Skrobson/SMIW/Hardware/PDF/Scheme.pdf

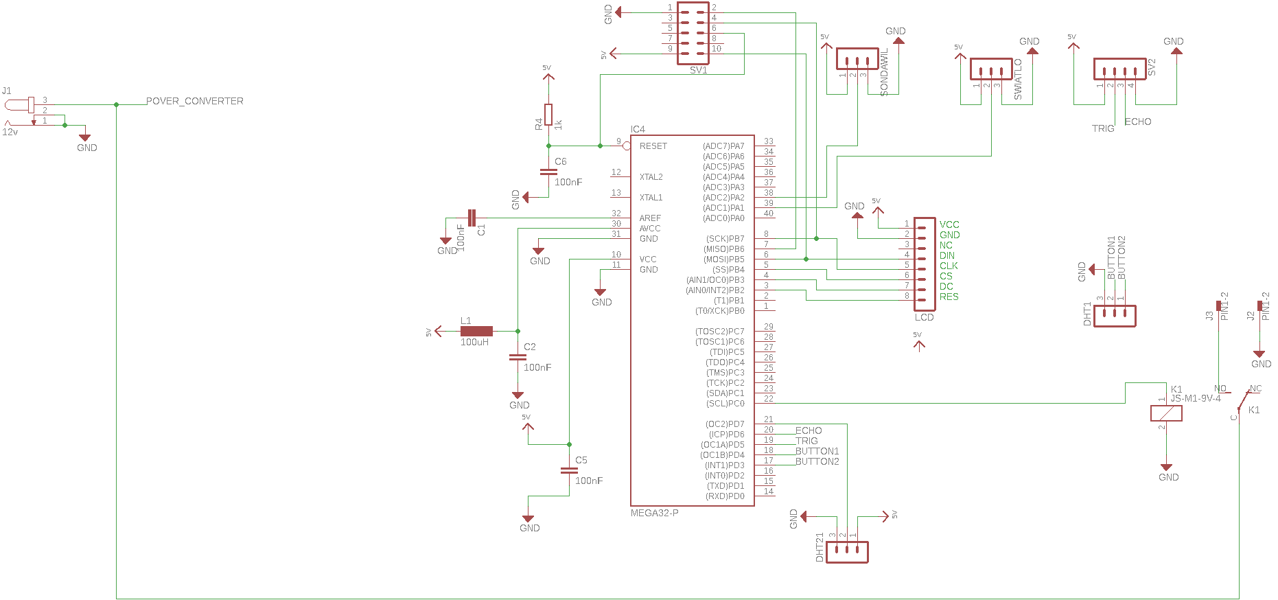
[picture p3: page 1]
