Skrobson/SMIW/Hardware/PDF/SchemePCB.pdf

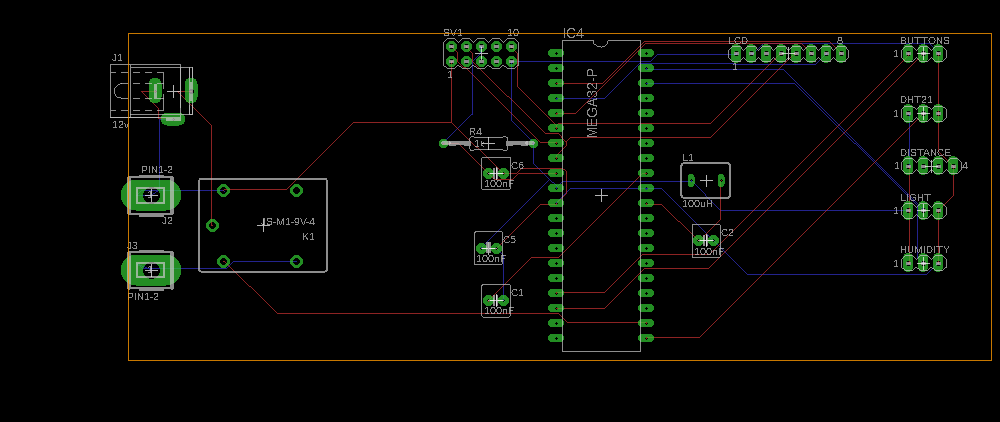
[picture p4: page 1]
