Skrobson/SMIW/Dokumentacja/Datasheet/mikrokontroler-avr-atmega32a-pu-dip.jpg

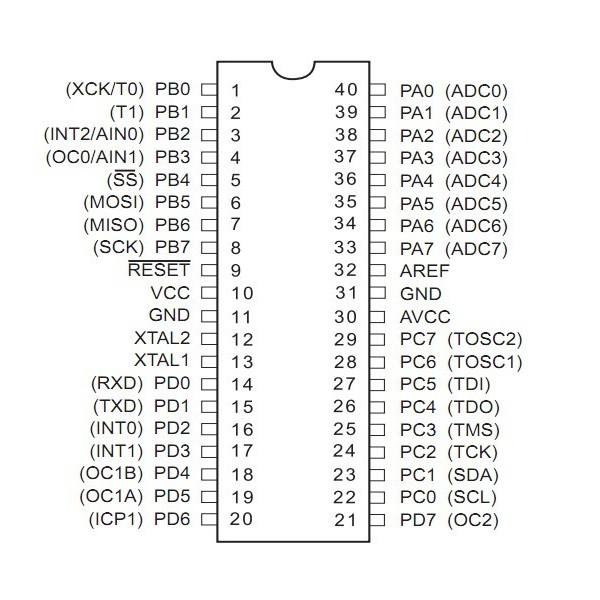
Dokumentacja/Datasheet/mikrokontroler-avr-atmega32a-pu-dip.jpg
