Skrobson/SMIW/Hardware/Eagle/schematPCB.brd

## EAGLE design Hardware/Eagle/schematPCB.brd (2018-09-15)

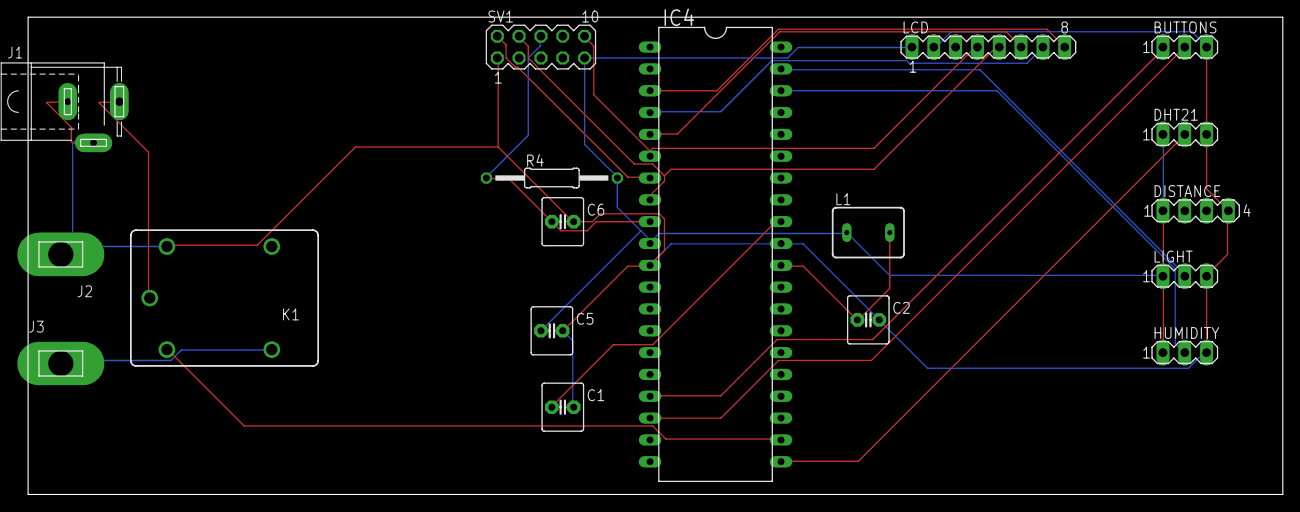
[picture p6: board schematPCB.brd from above]

Board: 2 copper layers, 146.0 x 55.5 mm, 18 parts (0 on the bottom side), 19 nets.

Parts:
BUTTONS: MA03-1
C1, C2, C5, C6: 100nF; C2.5-6
DHT21: MA03-1
DISTANCE: MA04-1
HUMIDITY: MA03-1
IC4: MEGA32-P; DIL40
J1: 12v; SPC4078
J2, J3: PIN1-2; 62221
K1: JS-M1-9V-4; JS-M
L1: 100uH; BS75
LCD: MA08-1
LIGHT: MA03-1
R4: 1k; 0207/15
SV1: MA05-2

Connections:
BUTTON1: BUTTONS.2, IC4.18
BUTTON2: BUTTONS.1, IC4.17
GND: BUTTONS.3, C1.2, C2.2, C5.2, C6.2, DHT21.3, DISTANCE.4, HUMIDITY.3, IC4.11, IC4.31, J1.1, J1.2, J2.1, K1.2, LCD.2, LIGHT.3, SV1.1
unnamed: IC4.39, LIGHT.2
unnamed: C6.1, IC4.9, R4.1, SV1.6
unnamed: IC4.6, LCD.4, SV1.10
unnamed: C1.1, IC4.32
unnamed: C2.1, IC4.30, L1.2
unnamed: IC4.8, LCD.5, SV1.4
unnamed: IC4.5, LCD.6
unnamed: IC4.4, LCD.7
unnamed: IC4.3, LCD.8
unnamed: DHT21.2, IC4.21
unnamed: J3.1, K1.NO
unnamed: HUMIDITY.2, IC4.38
unnamed: IC4.22, K1.1
unnamed: IC4.7, SV1.2
POVER_CONVERTER: J1.3, K1.C
VCC: C5.1, DHT21.1, DISTANCE.1, HUMIDITY.1, IC4.10, L1.1, LCD.1, LIGHT.1, R4.2, SV1.9
