Skrobson/SMIW/Software/SH1106.cpp

/*
 * SH1106.cpp
 *
 *  Created on: 28 cze 2018
 *      Author: skrobson
 */

#include "SH1106.h"
#include <util/delay.h>
#include <avr/pgmspace.h>

bool SH1106::initialized = false;
SH1106::SH1106() {

	if (!initialized)
	{
		spiInitMaster();


		restart();
		initialized = true;
	}
}

void SH1106::restart()
{
	DDRB |=(1<<PIN_CS);
		DDRB |=(1<<PIN_DC);
		DDRB |=(1<<PIN_RESET);

		PORTB &=~(1<<PIN_CS);

		PORTB |= (1<<PIN_RESET);
		_delay_ms(10);
		// Must reset LCD first!
		PORTB &= ~(1<<PIN_RESET);
		_delay_ms(10);
		PORTB |= (1<<PIN_RESET);

		command(0xAE);//--turn off oled panel
		command(0x02);//---set low column address
		command(0x10);//---set high column address
		command(0x40);//--set start line address  Set Mapping RAM Display Start Line (0x00~0x3F)
		command(0x81);//--set contrast control register
		command(0xA0);//--Set SEG/Column Mapping
		command(0xC0);//Set COM/Row Scan Direction
		command(0xA6);//--set normal display
		command(0xA8);//--set multiplex ratio(1 to 64)
		command(0x3F);//--1/64 duty
		command(0xD3);//-set display offset    Shift Mapping RAM Counter (0x00~0x3F)
		command(0x00);//-not offset
		command(0xd5);//--set display clock divide ratio/oscillator frequency
		command(0x80);//--set divide ratio, Set Clock as 100 Frames/Sec
		command(0xD9);//--set pre-charge period
		command(0xF1);//Set Pre-Charge as 15 Clocks & Discharge as 1 Clock
		command(0xDA);//--set com pins hardware configuration
		command(0x12);
		command(0xDB);//--set vcomh
		command(0x40);//Set VCOM Deselect Level
		command(0x20);//-Set Page Addressing Mode (0x00/0x01/0x02)
		command(0x02);//
		command(0xA4);// Disable Entire Display On (0xa4/0xa5)
		command(0xA6);// Disable Inverse Display On (0xa6/a7)
		command(0xAF);//--turn on oled panel

}

void SH1106::writeCmd(uint8_t data)
{
	PORTB &= ~(1<<PIN_DC);

	SPDR = data;
	while(! bit_is_set( SPSR, SPIF ));
}

void SH1106::write(uint8_t data)
{
	PORTB |= (1<<PIN_DC);

	SPDR = data;
	while(! bit_is_set( SPSR, SPIF ));
}

void SH1106::show()
{
	uint8_t page;

	for (page = 0; page < 8; page++)
	{
	        /* set page address */
		command(0xB0 + page);
	        /* set low column address */
	    command(0x02);
	        /* set high column address */
	    command(0x10);
	        /* write data */
	    for (int pixel = 0; pixel < 128; pixel++)
	    	write(screen[page*WIDTH + pixel]);
	 }
}

void SH1106::clear()
{
	  int i;
	  for(i = 0;i < WIDTH * HEIGHT / 8;i++)
		  screen[i] = 0;
}

void SH1106::pixel(int x, int y, char color, uint8_t* buffer)
{
    if(x > WIDTH || y > HEIGHT)return ;
    if(color)
        buffer[x+(y/8)*WIDTH] |= 1<<(y%8);
    else
        buffer[x+(y/8)*WIDTH] &= ~(1<<(y%8));
}

void SH1106::bitmap(uint8_t x, uint8_t y, const uint8_t *pBmp, uint8_t chWidth, uint8_t chHeight, uint8_t* buffer)
{
    uint8_t i,j,byteWidth = (chWidth + 7)/8;
    for(j = 0;j < chHeight;j++){
        for(i = 0;i <chWidth;i ++){
            if(pgm_read_byte(pBmp +j*byteWidth+i/8) & (128 >> (i & 7))){
                pixel(x+i,y+j,1,buffer);
            }
        }
    }
}

void SH1106::char1616(uint8_t x, uint8_t y, uint8_t chChar, uint8_t* buffer)
{
    uint8_t i, j;
    uint8_t chTemp = 0, y0 = y, chMode = 0;

    for (i = 0; i < 32; i ++) {
        chTemp = pgm_read_byte(&Font1612[chChar - 0x30][i]);

        for (j = 0; j < 8; j ++) {
            chMode = chTemp & 0x80? 1 : 0;
            pixel(x, y, chMode, buffer);
            chTemp <<= 1;
            y ++;

            if ((y - y0) == 16) {
                y = y0;
                x ++;
                break;
            }
        }
    }
}

void SH1106::writeChar(uint8_t x, uint8_t y, uint8_t acsii, uint8_t size, uint8_t mode, uint8_t* buffer)
{
    uint8_t i, j, y0=y;
    char temp;
    uint8_t ch = acsii - ' ';
    for(i = 0;i<size;i++) {
        if(size == 12)
        {
            if(mode)temp = pgm_read_byte(&Font1206[ch][i]);
            else temp = ~pgm_read_byte(&Font1206[ch][i]);
        }
        else
        {
            if(mode)temp = pgm_read_byte(&Font1608[ch][i]);
            else temp = ~pgm_read_byte(&Font1608[ch][i]);
        }
        for(j =0;j<8;j++)
        {
            if(temp & 0x80) pixel(x, y, 1, buffer);
            else pixel(x, y, 0, buffer);
            temp <<= 1;
            y++;
            if((y-y0) == size)
            {
                y = y0;
                x++;
                break;
            }
        }
    }
}

void SH1106::string(uint8_t x, uint8_t y, const char *pString, uint8_t Size, uint8_t Mode, uint8_t* buffer)
{
    while (*pString != '\0') {
        if (x > (WIDTH - Size / 2)) {
            x = 0;
            y += Size;
            if (y > (HEIGHT - Size)) {
                y = x = 0;
            }
        }

        writeChar(x, y, *pString, Size, Mode, buffer);
        x += Size / 2;
        pString++;
    }
}

void SH1106::char3216(uint8_t x, uint8_t y, uint8_t chChar, uint8_t* buffer)
{
    uint8_t i, j;
    uint8_t chTemp = 0, y0 = y, chMode = 0;

    for (i = 0; i < 64; i++) {
        chTemp = pgm_read_byte(&Font3216[chChar - 0x30][i]);
        for (j = 0; j < 8; j++) {
            chMode = chTemp & 0x80? 1 : 0;
            pixel(x, y, chMode, buffer);
            chTemp <<= 1;
            y++;
            if ((y - y0) == 32) {
                y = y0;
                x++;
                break;
            }
        }
    }
}

const uint8_t Waveshare12864[1024] PROGMEM =
{
    0x00,0x00,0x00,0x00,0x00,0x00,0x00,0x00,0x00,0x00,0x00,0x00,0x00,0x00,0x00,0x00,
    0x00,0x00,0x00,0x00,0x00,0x00,0x00,0x00,0x00,0x00,0x00,0x00,0x00,0x00,0x00,0x00,
    0x11,0x11,0x00,0x9C,0x64,0x42,0x1C,0x78,0x7A,0x78,0xEF,0xB8,0x30,0x89,0x8C,0x70,
    0x19,0x91,0x88,0x9C,0xF4,0x63,0x1E,0x78,0x7A,0x79,0xEF,0x3C,0x78,0x89,0x9E,0xF0,
    0x09,0x91,0x88,0xB1,0x84,0x63,0x12,0x40,0x42,0x43,0x02,0x24,0xCC,0xC9,0x30,0x80,
    0x09,0x91,0x88,0xB1,0x84,0x67,0x12,0x40,0x42,0x42,0x02,0x24,0x84,0xC9,0x20,0x80,
    0x09,0x92,0x89,0xB0,0x84,0x65,0x12,0x40,0x42,0x42,0x02,0x24,0x84,0xC9,0x20,0xC0,
    0x0A,0xB2,0x4D,0x1C,0xC7,0xE5,0x96,0x78,0x7A,0x72,0x02,0x2C,0x84,0xA9,0x20,0x60,
    0x0A,0xA2,0x45,0x14,0x67,0xE4,0x9C,0x70,0x72,0x52,0x02,0x38,0x84,0xA9,0x20,0x30,
    0x0A,0x63,0xC5,0x30,0x34,0x67,0x94,0x40,0x42,0x42,0x02,0x28,0x84,0xB9,0x20,0x10,
    0x06,0x67,0xC7,0x30,0x14,0x6F,0x92,0x40,0x42,0x42,0x02,0x24,0x84,0x99,0x20,0x10,
    0x06,0x64,0x66,0x30,0x14,0x68,0x92,0x40,0x42,0x43,0x02,0x24,0x8C,0x99,0x20,0x10,
    0x06,0x64,0x22,0x3D,0xB4,0x68,0xD3,0x78,0x7A,0x79,0xE2,0x26,0x78,0x89,0xBE,0xF0,
    0x04,0x44,0x22,0x1C,0xE4,0x48,0x51,0x78,0x7A,0x79,0xE2,0x22,0x70,0x89,0x9E,0xE0,
    0x00,0x00,0x00,0x00,0x00,0x00,0x00,0x00,0x00,0x00,0x00,0x00,0x00,0x00,0x00,0x00,
    0x00,0x00,0x00,0x00,0x00,0x00,0x00,0x00,0x00,0x00,0x00,0x00,0x00,0x00,0x00,0x00,
    0x00,0x00,0x00,0x00,0x00,0x00,0x00,0x00,0x00,0x00,0x00,0x00,0x00,0x00,0x00,0x00,
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
};

const uint8_t Bluetooth88[8] PROGMEM = // bluetooth
{
    0x18,0x54,0x32,0x1C,0x1C,0x32,0x54,0x18
};

const uint8_t GPRS88[8] PROGMEM = //GPRS
{
    0xC3,0x99,0x24,0x20,0x2C,0x24,0x99,0xC3
};

const uint8_t Alarm88[8] PROGMEM = //alram
{
    0xC3,0xBD,0x42,0x52,0x4E,0x42,0x3C,0xC3
};
