Skrobson/SMIW/Software/dht.h

/*
DHT Library 0x03

copyright (c) Davide Gironi, 2012

Released under GPLv3.
Please refer to LICENSE file for licensing information.

References:
  - DHT-11 Library, by Charalampos Andrianakis on 18/12/11
*/


#ifndef DHT_H_
#define DHT_H_

#include <stdio.h>
#include <avr/io.h>

//setup port
#define DHT_DDR DDRD
#define DHT_PORT PORTD
#define DHT_PIN PIND
#define DHT_INPUTPIN PD7

//sensor type
#define DHT_DHT11 1
#define DHT_DHT22 2
#define DHT_TYPE DHT_DHT22

//enable decimal precision (float)
#if DHT_TYPE == DHT_DHT11
#define DHT_FLOAT 0
#elif DHT_TYPE == DHT_DHT22
#define DHT_FLOAT 0
#endif

//timeout retries
#define DHT_TIMEOUT 200

//functions
#if DHT_FLOAT == 1
extern int8_t dht_gettemperature(float *temperature);
extern int8_t dht_gethumidity(float *humidity);
extern int8_t dht_gettemperaturehumidity(float *temperature, float *humidity);
#elif DHT_FLOAT == 0
int8_t dht_gettemperature(int8_t *temperature);
int8_t dht_gethumidity(int8_t *humidity);
int8_t dht_gettemperaturehumidity(int8_t *temperature, int8_t *humidity);
#endif

#endif
