Skrobson/SMIW/(commit log)

2018-08-08 working distance sensor
2018-09-08 reorganizacja projektu
    [schemat.sch, smiw_eszklarnia.xlsx]
2018-09-15 Schemat PCB
    [schemat.sch, schematPCB.brd]
