Skrobson/SMIW/(notices)

Notices in the files:
parts and their libraries:
MAX9812: License : GNU General Public License version 2 (see bottom)
